Makerfabs/Home-Assistant-Energy-Meter/README.md

# Makerfabs Home Assistant Energy Meter

## Intruduce

[Product Link]()

[Wiki Link](https://wiki.makerfabs.com/How%20to%20use%20Energy%20Meter%20for%20Home%20Assistant.html)
