Makerfabs/Home-Assistant-Energy-Meter/hardware/Energy Meter for Home Assistant V1.0.PDF

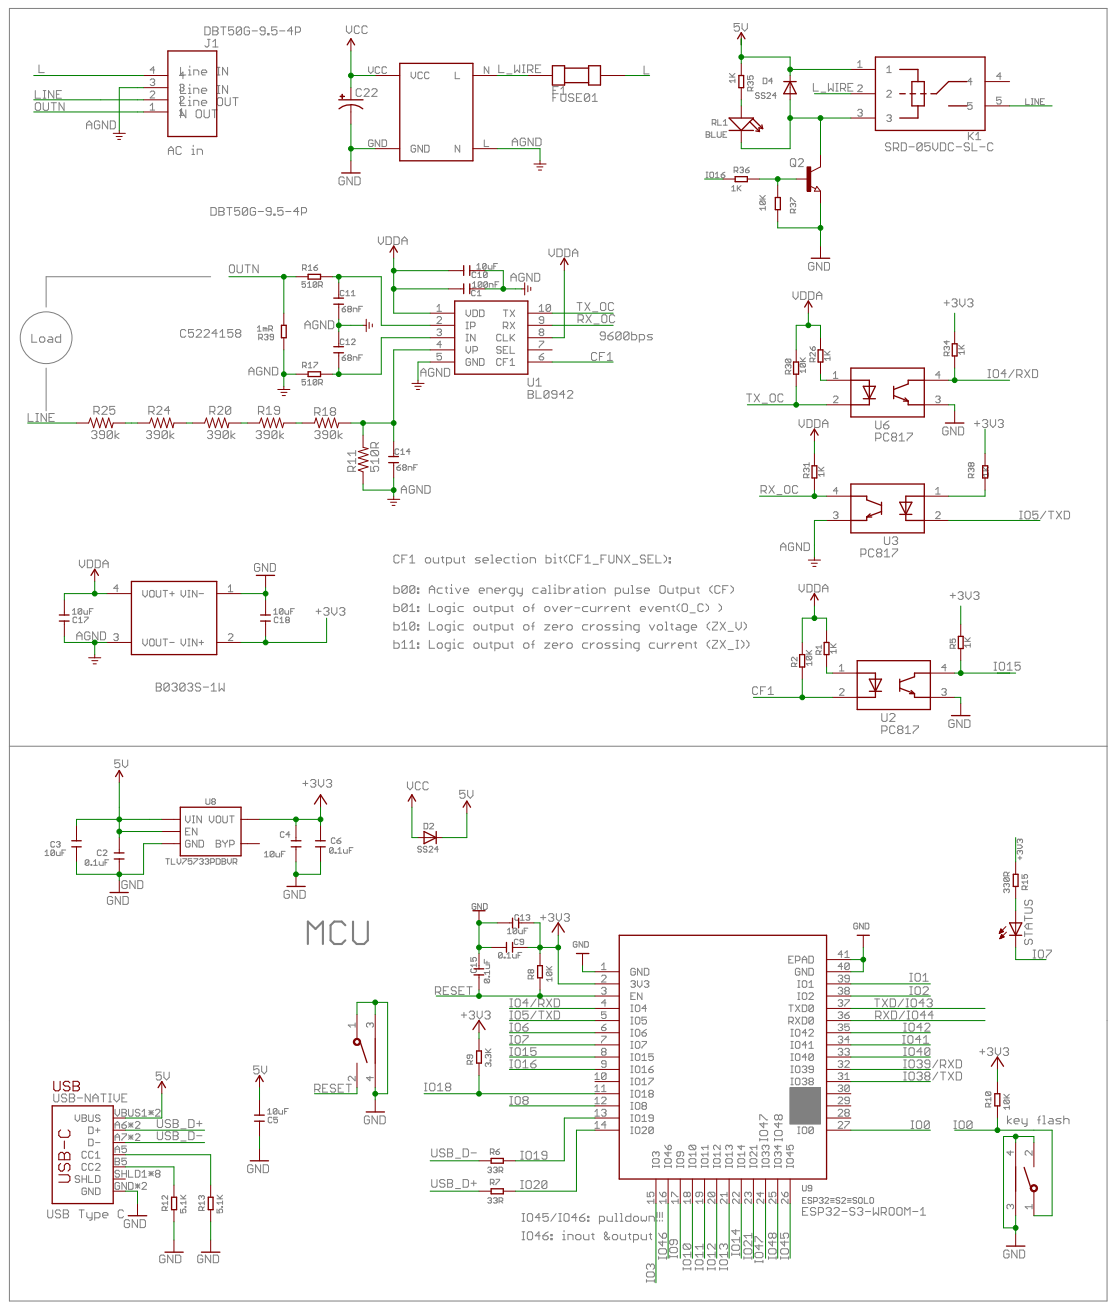
[picture p1: page 1]
