Makerfabs/Home-Assistant-Energy-Meter/hardware/Energy Meter for Home Assistant V1.1.brd

## EAGLE design hardware/Energy Meter for Home Assistant V1.1.brd (2026-01-03)

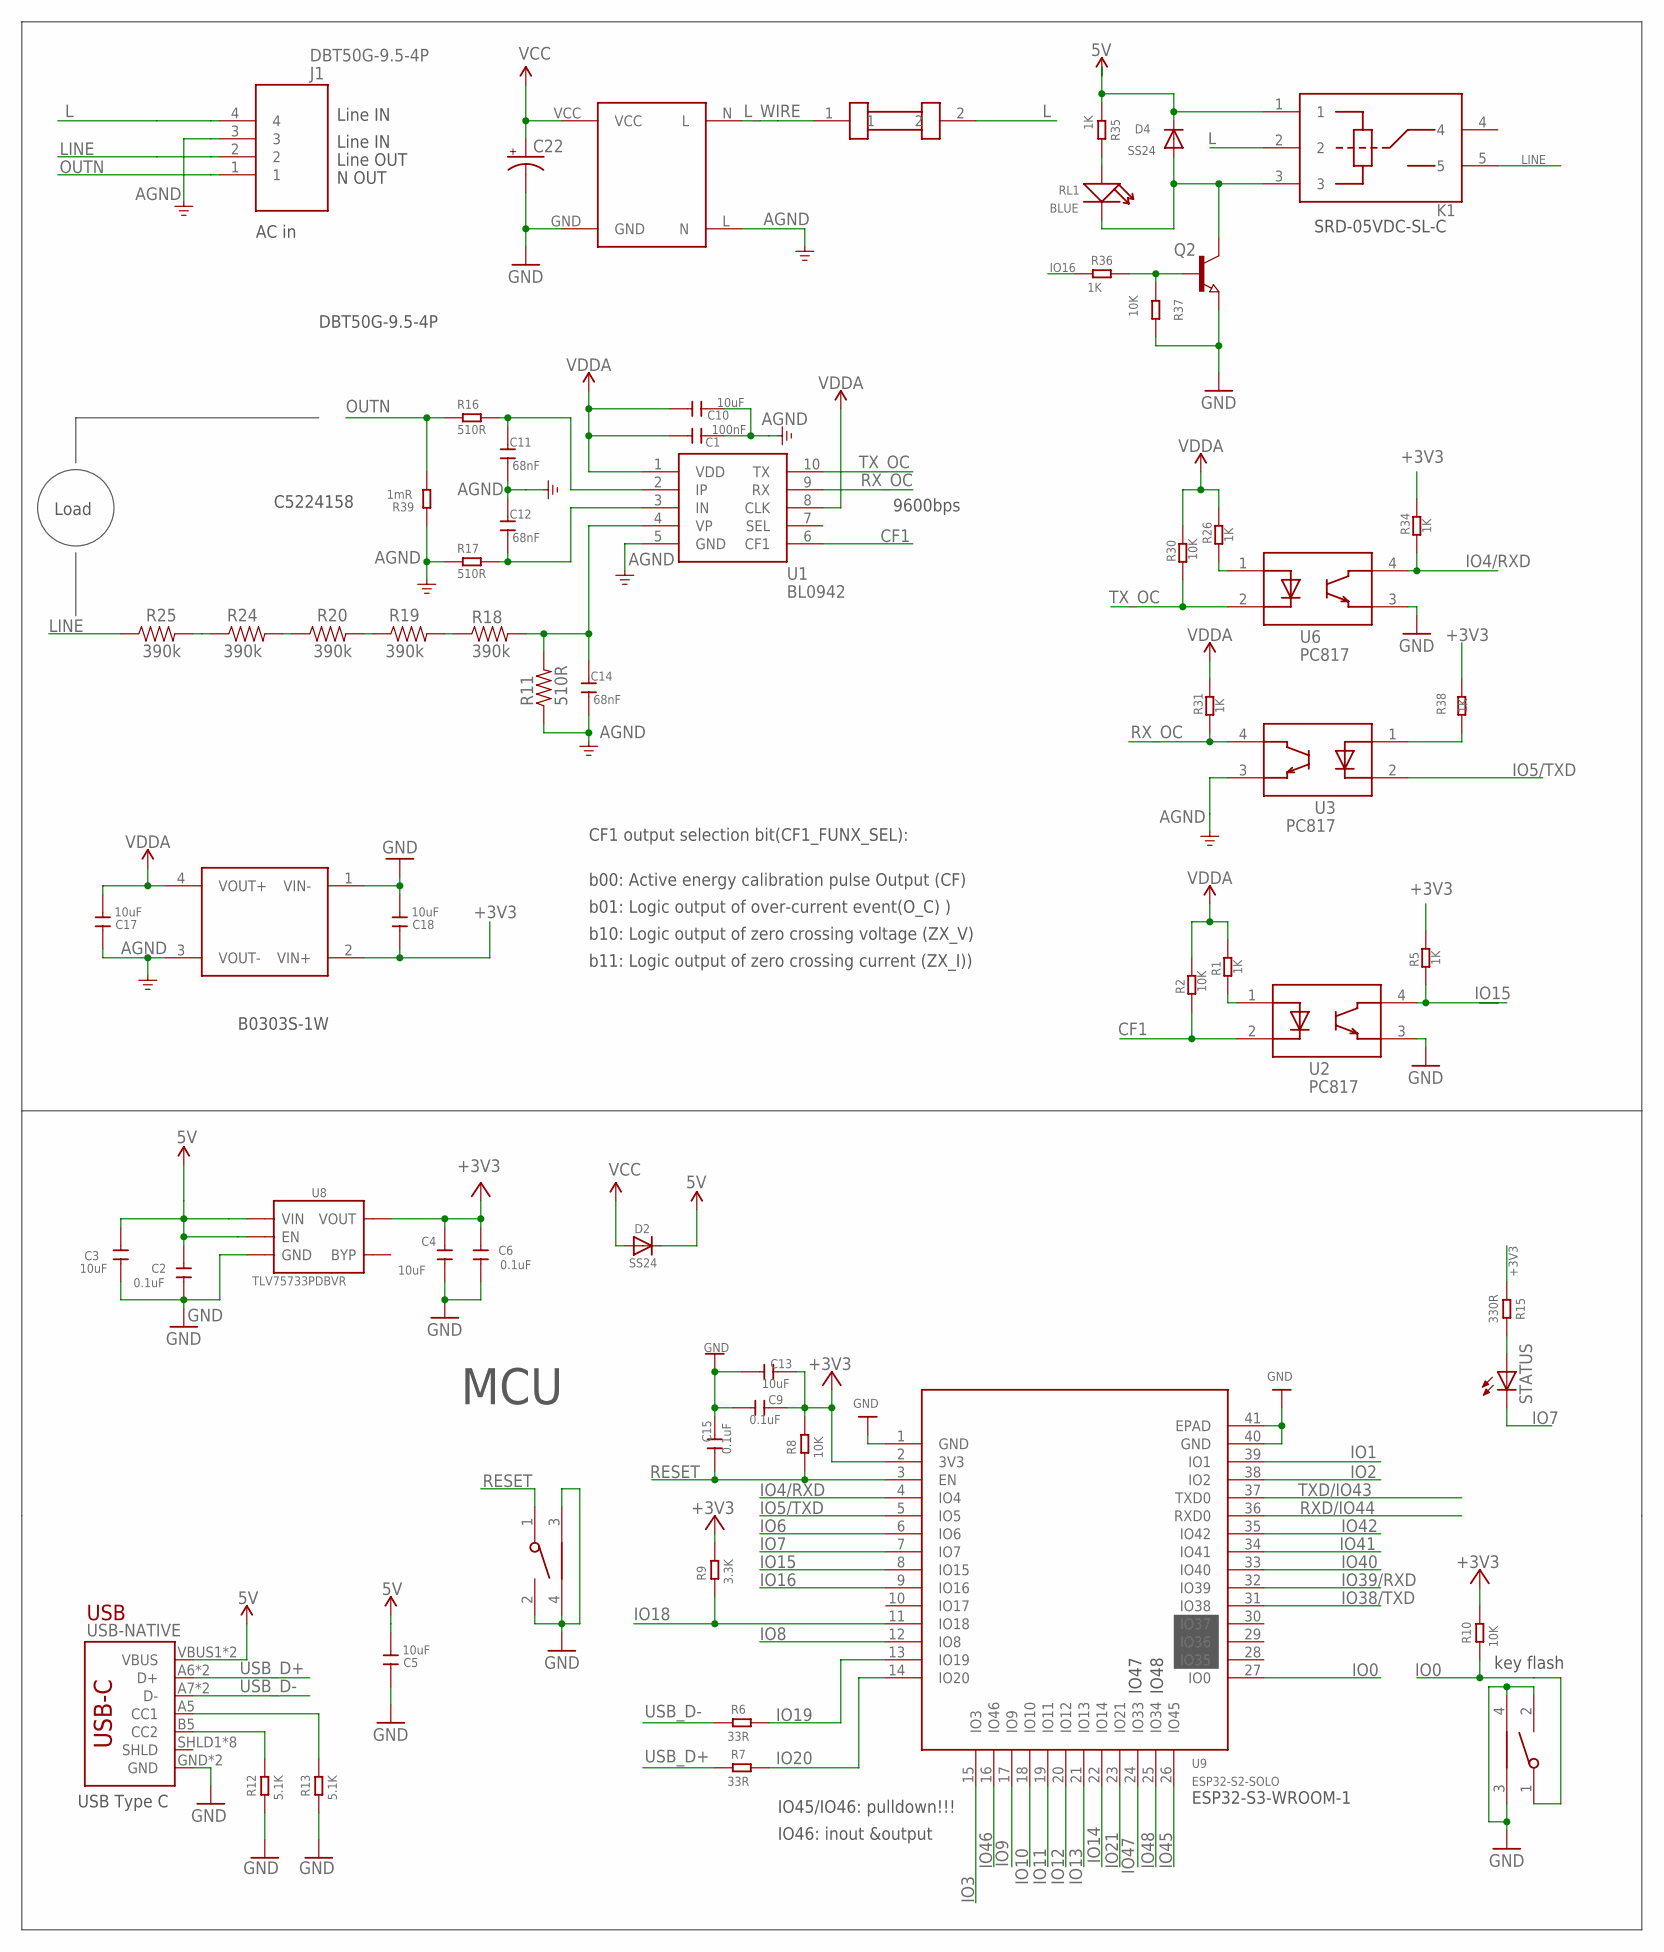
[picture p2: schematic Energy Meter for Home Assistant V1.1.sch]

Parts:
BOOT: TS24CA; 2*4*3.5MM
C1: 100nF; 0603
C2, C6, C9, C15: 0.1uF; 0603
C3, C4, C5, C10, C13, C17, C18: 10uF; 0603
C11, C12, C14: 68nF; 0603
C22: CAP_POL3528-KIT; EIA3528-KIT
D2, D4: SS24; SMADIODE
F1: FUSE01; FUSE01-D4XL11
J1: DBT50G-9.5-4P
K1: JQC3FF; DIP5_JQC3FF
Q2: NPN-TRANSISTOR_SOT23; SOT23
R1, R5, R26, R31, R34, R35, R36, R38: 1K; R0603
R2, R8, R10, R30, R37: 10K; R0603
R6, R7: 33R; R0603
R9: 3.3K; R0603
R11: 510R; 1206
R12, R13: 5.1K; R0603
R15: 330R; R0603
R16, R17: 510R; R0603
R18, R19, R20, R24, R25: 390k; 1206
R39: 1mR; DISCRETE_R2512
RL1: BLUE; LED-0603
RST: TS24CA; 2*4*3.5MM
STATUS: LED5MM
U1: BL0942; SOP8-100P-600L500W175H
U2, U3, U6: PC817; SMD4-254P-1016L460W
U5: AC-DCHLK01; HLK-PM01
U7: B0303S
U8: TLV75733PDBVR; SOT23-5
U9: ESP32­S2­SOLO; ESP32-­S2-­SOLO
USB-NATIVE: USB_C5; USB-C-16P-5

Connections:
5V: C2.2, C3.2, C5.1, D2.C, D4.C, K1.1, R35.1, U8.1 (VIN), U8.3 (EN), USB-NATIVE.VBUS1 (VBUS), USB-NATIVE.VBUS2 (VBUS)
+3V3: C4.2, C6.2, C9.2, C13.2, C18.2, R5.2, R8.2, R9.2, R10.2, R15.1, R34.2, R38.2, U7.2 (VIN+), U8.5 (VOUT), U9.2 (3V3)
AGND: C1.1, C10.1, C11.2, C12.1, C14.2, C17.2, J1.3, R11.1, R17.2, R39.1, U1.5 (GND), U3.3, U5.L (N), U7.3 (VOUT-)
CF1: R2.1, U1.6 (CF1), U2.2
GND: BOOT.2, BOOT.3, BOOT.4, C2.1, C3.1, C4.1, C5.2, C6.1, C9.1, C13.1, C15.2, C18.1, C22.C (-), Q2.2 (E), R12.1, R13.1, R37.2, RST.2, RST.3, RST.4, U2.3, U5.GND, U6.3, U7.1 (VIN-), U8.2 (GND), U9.1 (GND), U9.40 (GND), U9.41 (EPAD), USB-NATIVE.GND, USB-NATIVE.GND2 (GND)
IO0: BOOT.1, R10.1, U9.27 (IO0)
IO1: U9.39 (IO1)
IO2: U9.38 (IO2)
IO3: U9.15 (IO3)
IO4/RXD: R34.1, U6.4, U9.4 (IO4)
IO5/TXD: U3.2, U9.5 (IO5)
IO6: U9.6 (IO6)
IO7: STATUS.K (C), U9.7 (IO7)
IO8: U9.12 (IO8)
IO9: U9.17 (IO9)
IO10: U9.18 (IO10)
IO11: U9.19 (IO11)
IO12: U9.20 (IO12)
IO13: U9.21 (IO13)
IO14: U9.22 (IO14)
IO15: R5.1, U2.4, U9.8 (IO15)
IO16: R36.1, U9.9 (IO16)
IO18: R9.1, U9.11 (IO18)
IO19: R6.2, U9.13 (IO19)
IO20: R7.2, U9.14 (IO20)
IO21: U9.23 (IO21)
IO38/TXD: U9.31 (IO38)
IO39/RXD: U9.32 (IO39)
IO40: U9.33 (IO40)
IO41: U9.34 (IO41)
IO42: U9.35 (IO42)
IO45: U9.26 (IO45)
IO46: U9.16 (IO46)
IO47: U9.24 (IO33)
IO48: U9.25 (IO34)
L: F1.2, J1.4, K1.2
LINE: J1.2, K1.5, R25.1
L_WIRE: F1.1, U5.N (L)
unnamed: R1.1, U2.1
unnamed: R15.2, STATUS.A
unnamed: R13.2, USB-NATIVE.A5 (CC1)
unnamed: R38.1, U3.1
unnamed: C11.1, R16.1, U1.2 (IP)
unnamed: C12.2, R17.1, U1.3 (IN)
unnamed: R26.1, U6.1
unnamed: R12.2, USB-NATIVE.B5 (CC2)
unnamed: C14.1, R11.2, R18.2, U1.4 (VP)
unnamed: R20.1, R24.2
unnamed: R24.1, R25.2
unnamed: R35.2, RL1.+
unnamed: D4.A, K1.3, Q2.3 (C), RL1.-
unnamed: Q2.1 (B), R36.2, R37.1
unnamed: R19.1, R20.2
unnamed: R18.1, R19.2
OUTN: J1.1, R16.2, R39.2
RESET: C15.1, R8.1, RST.1, U9.3 (EN)
RXD/IO44: U9.36 (RXD0)
RX_OC: R31.1, U1.9 (RX), U3.4
TXD/IO43: U9.37 (TXD0)
TX_OC: R30.1, U1.10 (TX), U6.2
USB_D+: R7.1, USB-NATIVE.A6 (D+), USB-NATIVE.B6 (D+)
USB_D-: R6.1, USB-NATIVE.A7 (D-), USB-NATIVE.B7 (D-)
VCC: C22.A (+), D2.A, U5.VCC
VDDA: C1.2, C10.2, C17.1, R1.2, R2.2, R26.2, R30.2, R31.2, U1.1 (VDD), U1.8 (CLK), U7.4 (VOUT+)

Notes on the sheet:
AC in
SRD-05VDC-SL-C
C5224158
B0303S-1W
DBT50G-9.5-4P
Line IN
Line OUT
N OUT
Load
IO45/IO46: pulldown!!!
IO46: inout &output
USB
USB Type C
MCU
ESP32-S3-WROOM-1
IO47
IO48
key flash
9600bps
b00: Active energy calibration pulse Output (CF)
b01: Logic output of over-current event(O_C) )
b10: Logic output of zero crossing voltage (ZX_V)
b11: Logic output of zero crossing current (ZX_I))
CF1 output selection bit(CF1_FUNX_SEL):

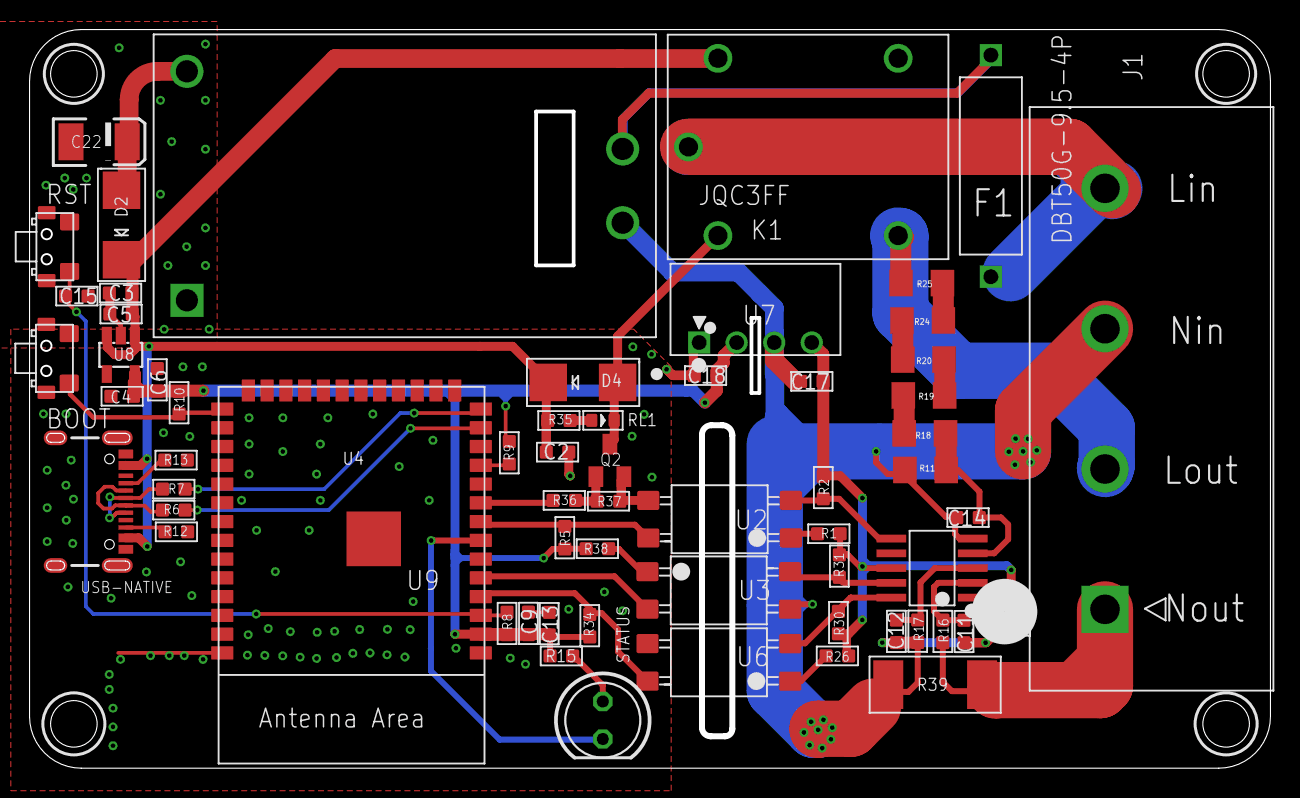
[picture p3: board Energy Meter for Home Assistant V1.1.brd from above]

Board: 2 copper layers, 84.0 x 50.0 mm, 64 parts (1 on the bottom side), 41 nets.

Other parts of the board:
U$1: MAKERFABS_0.3
